LoloxonCc/ExoScout/Reviews/PDR_Redacted.pdf

## ExoScout Preliminary Design Review


## Team Name: ExoScout

### Table of Contents

1 INTRODUCTION

3
1.1 Team organisation and roles

3
1.2 Mission objectives

5
2 CANSAT

DESCRIPTION

7
2.1 Mission overview

7
2.2 Mechanical/structural design

8
2.3 Electrical design | 12
2.4 Software design | 12
2.5 Recovery system | 12
2.6 Ground support equipment | 14
3 PROJECT
PLANNING | 15
3.1 Time schedule | 15
3.2 Task list | 15
3.3 Resource estimation | 16
3.3.1 Budget | 16
4 OUTREACH PROGRAMME | 17

### 1 INTRODUCTION

1.1 Team organisation and roles
Team consists of 6 students from V High School in Bielsko-Biała, where we pursue extended programmes in math, physics and computer science. Although all of us realise the same extended subjects we present a wide variety of interdisciplinary interests and abilities. We see the CanSat competition as a great opportunity to broaden our knowledge and get experience in this type of team work. On top of that we are supported by our teacher and one of our older schoolmates, who is our mentor.
- teacher:
| ● Background:
| ● Field of work: Supervision of the team’s progress.
- mentor:
| ● Background:
| ● Field of work: Consultation. ● Hours dedicated weekly: 1 hour for consultations

Karol Synowiec - team leader:

| ● Background: Interested in math, physics and engineering. He likes understanding how machines work and is eager to explore new science achievements especially those concerning space exploration and physics related to it. He participates in contests such as Math Olympiad, Physics Olympiad, Diament AGH and more. ● Fields of work: CanSat 3D modelling in Fusion 360, electronics and team leader ● Hours dedicated weekly: 10 hours
- team member:
| ● Background:

1 https://spacecamp.no/
3

- Field of work: Software concerning sensors
- Hours dedicated weekly: 12 hours
- team member:
- Background:
- Field of work: Mechanical system development and design
- Hours dedicated weekly: 5 hours
- team member:
- Background:
- Fields of work: Recovery system, CanSat assemblement.
- Hours dedicated weekly: 10 hours
- team member:
- Background:
- Fields of work: software concerning soil intake, electronics.
- Hours dedicated weekly: 5 hours
- team member:
- Background:

4

- Fields of work: outreach, promotion
- Hours dedicated weekly: 5 hours
1.2 | Mission objectives
1.3 | Our vision
In our project we want to create CanSat which will act as a “scout” for a mission looking for a planet that can be settled by humans. After first assessments of a planet's potential habitability from space, a CanSat like device will be dropped on the planet's surface and will carry out further measurements of factors crucial to the life of the humankind. Data collected from primary and secondary missions will be used with a view to analyse multiple factors, which are considered to be vital for planetary habitability.

1.4 Primary mission
Primary mission is to measure air temperature and air pressure and to transmit it as a telemetry once per second to the ground station. Data collected from it will be used to assess if water can be liquid on the planet’s surface²

. Temperature limit for life³

is in
the range of 0 to 113 degrees Celsius, which will be also evaluated based on those measurements.

1.5 Secondary mission
Secondary mission will collect more specific data about the planet. In order to do that we divide it into the two main stages:
1. During fall CanSat will measure factors concerning planetary habitability:
| ○ Gravitational acceleration - Too high value of it makes any motion harder, blood can’t freely flow and bones can be broken due to overload⁴⁵. On the other hand low gravity implies low escape velocity, it results in molecules leaving the planet more easily and destroying its atmosphere⁶
| ○ Cosmic radiation (UV) - Radiation is both helpful and harmful⁷

. UV
| radiation takes part in biosphere processes but also affects human health. Too much of it can result in cancer but it is crucial for vitamin D3 synthesis in the body. ○ Magnetic field - without proper magnetic field the planet is not protected from stellar wind and cosmic radiation, which destroys its atmosphere and puts life at risk of being bombarded with ionized particles⁸

8 Significance part from: https://en.wikipedia.org/wiki/Earth%27s_magnetic_field

7 https://www.cdc.gov/nceh/features/uv-radiation-safety/index.html

6 extract about mass and size and hence planets gravity from https://en.m.wikipedia.org/wiki/Planetary habitability

5 https://arxiv.org/pdf/1808.07417.pdf,

4 https://www.astronomy.com/science/whats-the-maximum-gravity-we-could-survive/

3 Table 1 on page 185 http://www.geology.wisc.edu/astrobiology/docs/Lammer_et_al_2009_Astron_Astro_Rev.pdf

2 Liquid water importance from abstract of: https://pubmed.ncbi.nlm.nih.gov/11539468/

5

- Atmosphere O2 content - oxygen is vital to life as we know it. The reduction of oxygen provides one of the largest free energy release per electron transfer⁹

, so it is a great source of energy for complex life.
2. Vertical landing and taking a soil sample with Archimedes screw-like device¹⁰ to measure its humidity:
- Analysis of soil helps in the search for past water activities. Mineralogy of it is important in determining the processes that created the planet. Soil is widely analysed by rovers (f.e. on Mars)¹¹

1.6 Assessment
In conditions of the launch campaign on Earth we will test the measurements correctness by comparing them with those measured by more sophisticated devices. From the mechanical side we want to test if we can make CanSat land vertically by reducing its speed and using side stabilizers.

11 https://mars.nasa.gov/resources/4910/inspecting-soils-across-mars/

10 https://en.wikipedia.org/wiki/Archimedes%27 screw

9 https://earthscience.rice.edu/wp-content/uploads/2015/08/Catling-Astrobiology-2005.pdf

6

### 2 CANSAT DESCRIPTION

2.1 Mission overview
After launch from a rocket at a destined altitude (1500m-2500m) CanSat will deploy a parachute and side stabilizers. During the fall the device will start its measurements and reach terminal velocity of around 6 m/s in order to land vertically which will enable us to collect soil with Archimedes Screw-like mechanism after landing.

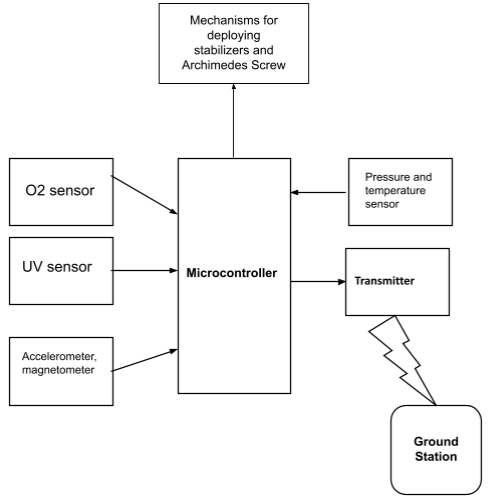
[picture p40: figure]

7

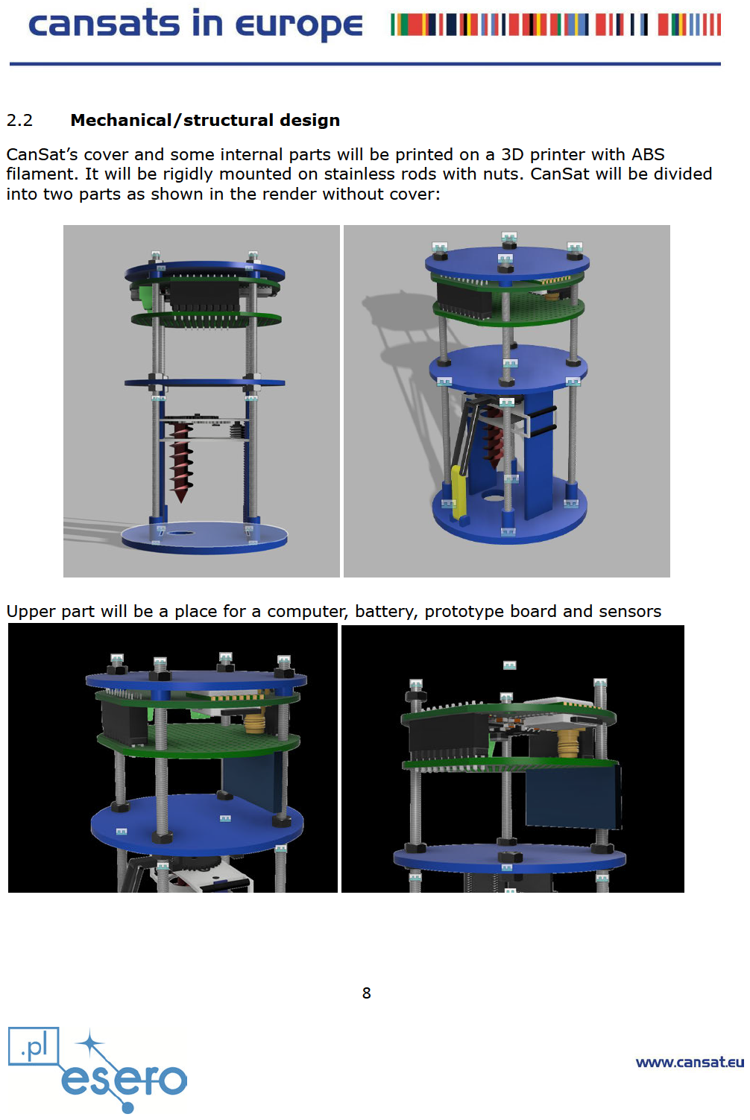
[picture p41: page 8]
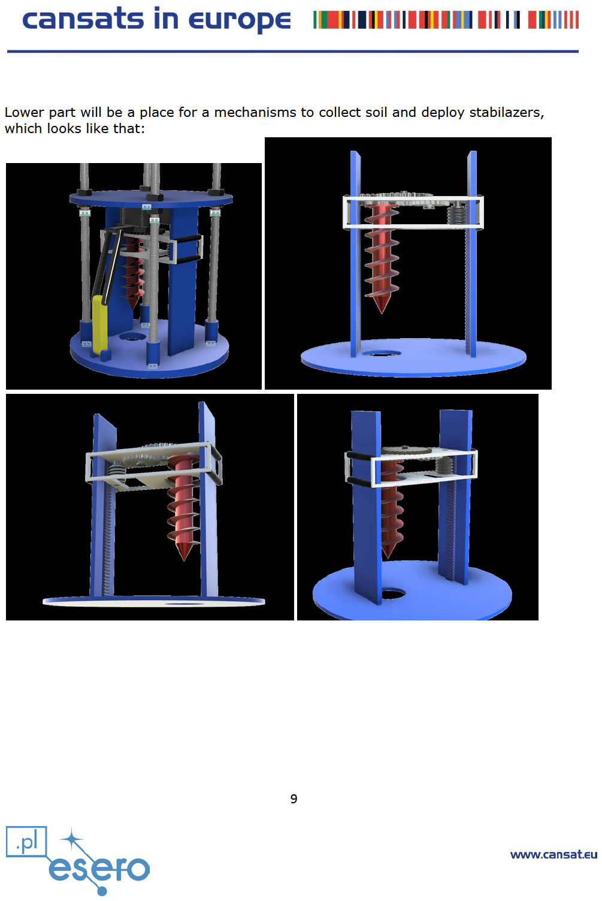
[picture p42: page 9]
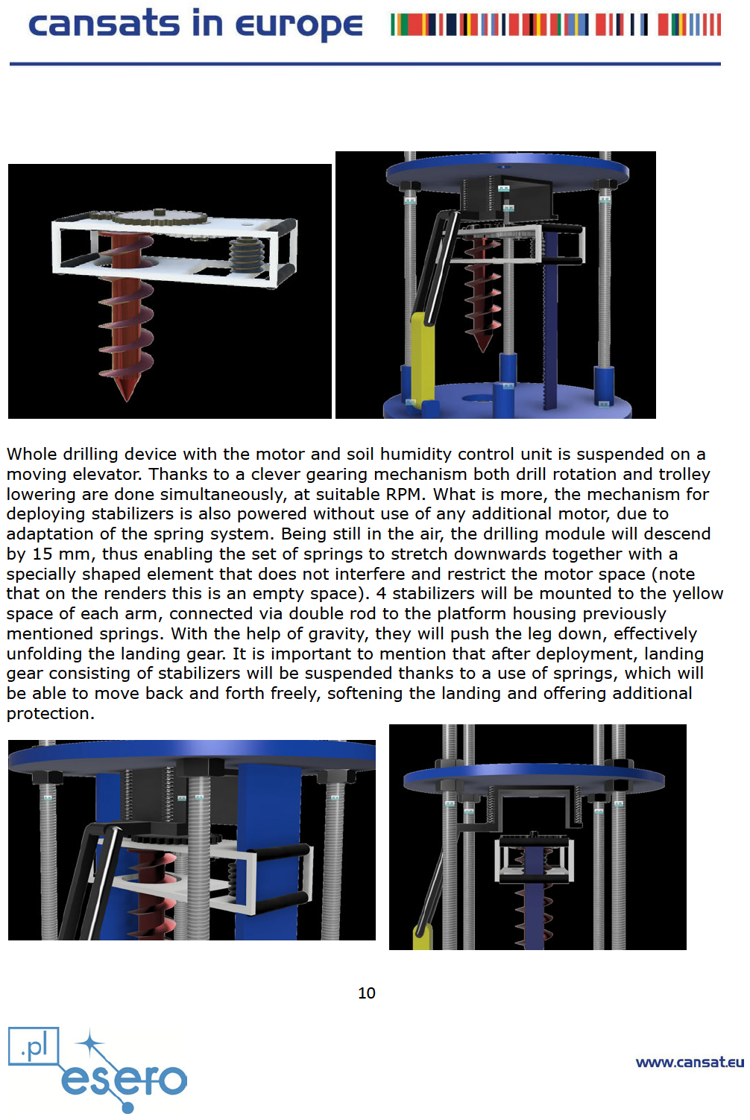
[picture p43: page 10]
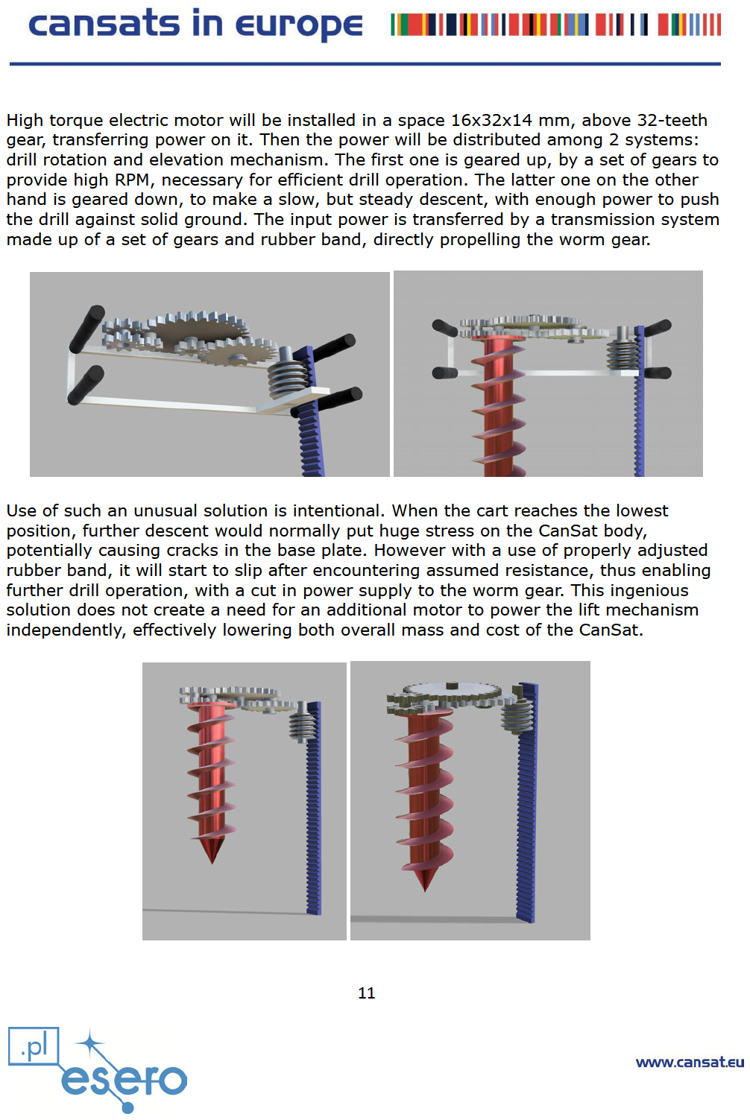
[picture p44: page 11]

Mass estimated by Fusion 360, after applying the right materials, is around 204g. After adding sensors, side stabilisers, parachute and soil intake mechanism mass will be in the range of 300-350g.

2.3 Electrical design
Electrical design includes:
| ● Computer - from CanSat kit ● Proto board - from CanSat kit ● Battery - capacity will be estimated later ● Primary mission sensors - temperature and pressure sensors from CanSat kit ● Secondary mission sensors: ○ UV sensor e.g: https://botland.store/sensors-of-light-and-color/19004-ltr390-uv-ultraviol et-light-sensor-stemma-qt-5903351249423.html ○ O2 sensor e.g: https://botland.store/gravity-gas-dust-sensors/20981-gravity-o2-sensor-i 2c-uart-factory-calibrated-dfrobot-sen0465-5904422383299.html ○ Accelerometer and magnetometer: https://botland.store/9dof-imu-sensors/17709-icm-20948-9dof-3-axis-ac celerometer-gyroscope-and-magnetometer-i2cspi-qwiic-adafruit-4554-59 04422378677.html ○ Servomotor: https://botland.com.pl/silniki-micro-pololu-seria-hp-high-power/246-silni k-hp-1001-pololu-1101-5904422306106.html

2.4 Software design
In primary mission software should plot measured temperature and pressure as a point on phase diagram¹² in order to check if water is liquid in these conditions.
In the secondary mission software will check if measured factors are in range optimal for life and send information to ground stations. Data should be live displayed on laptops with use of software like Grafana¹³. Program will also launch side stabilisers after drop from the racket and start the Archimedes screw after landing.

2.5 Recovery system¹⁴
Parachute will be made out of nylon and will have a hemispherical shape. It will be attached to the CanSat with four lines. Its area can be obtained from the equation for equilibrium of forces:

14 https://cansat.esa.int/design-your-parachute/

13 https://grafana.com/

12 https://openstax.org/books/chemistry-2e/pages/10-4-phase-diagrams

12

mg =

1
2

C
D

ρAv²
Where: m - mass of the CanSat, g - Earth acceleration, CD - drag coefficient of parachute, ρ - density of air and v is terminal velocity.
After some careful conversions we get:

A = 2mg
C
D

ρv

2
Substituting values:
g=9.81 m/s²

, CD=0.62, ρ=1.204 kg/m³

, v=6 m/s, m in range of 0.3 to 0.35 kg

We get:

0. 219 m² ≤ A ≤ 0. 255 m²
Shape of hemispherical parachute:

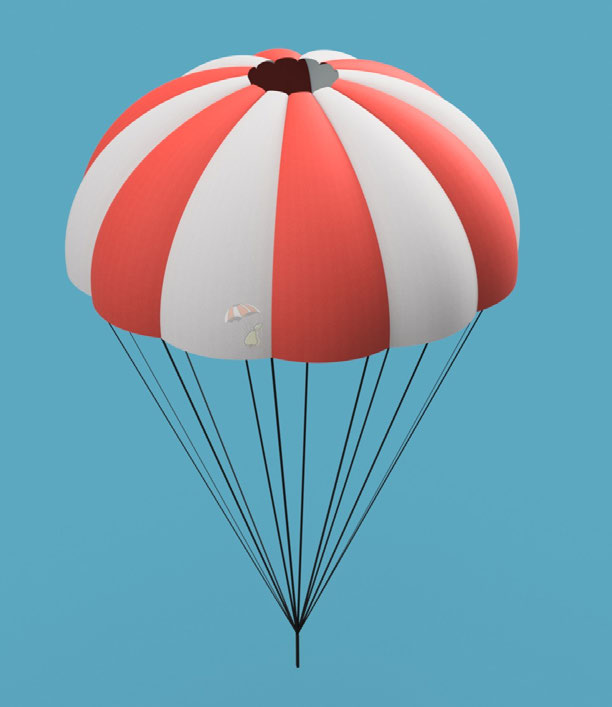
[picture p45: figure]

13

2.6 Ground support equipment¹⁵

Data from the CanSat will be transmitted to the ground station. Equipment concerned with these will consist of:
| ● Yagi-Uda antenna:

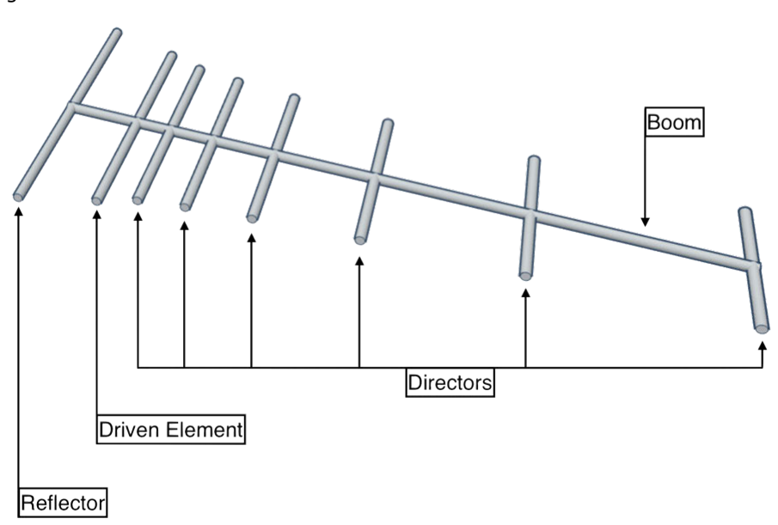
[picture p46: figure]

- Computer to display received data
- Adafruit Feather M0 RFM96 LoRa Radio for communication of antenna and the computer

15 https://cansat.esa.int/communicating-with-radio/
14

### 3 PROJECT PLANNING

3.1 Time schedule
We decided to prepare PDR in 4 one week intervals, first was for collecting information and sources for the report, second was for writing the initial version of it, third for making it more detailed and the last one for last corrections. After PDR we plan to schedule work, on each phase of the project, in 3 week-long intervals. As of now we separated 5 main stages, namely: design, prototyping, construction, tests and writing CDR. They will consist of subparts. We make a rather strict schedule (tests should start before Q&A with Jury on 9 January 2024) to make sure that even if we fail to keep some dates we can take one more week to work better on some stage of the project. Materials to write CDR such as: notes, designs, etc. will be collected during all phases and consequently put together into the report. Gantt chart presenting our schedule until CDR (from Asana):

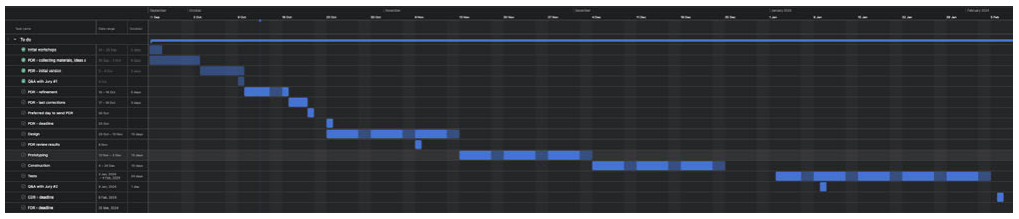
[picture p47: figure]

3.2 Task list

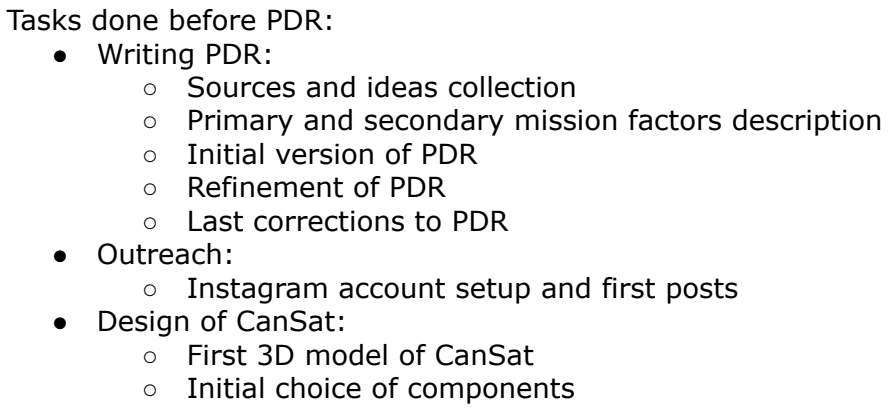
[picture p48: figure]
Tasks done before PDR: ● Writing PDR: ○ Sources and ideas collection; ○ Initial version of PDR ○ Refinement of PDR ○ Last corrections to PDR ● Outreach:; ● Design of CanSat: ○ First 3D model of CanSat ○ Initial choice of components

- Primary and secondary mission factors description
- Instagram account setup and first posts

15

Tasks to be done before CDR:
- Design:
- 3D model of CanSat with all details
- Parachute design
- Ground station design
- Electrical design
- Detailed description of software
- Prototyping
- Writing software
- Checking if parts work alone
- Making a parachute
- Construction
- Assembling all parts into a CanSat
- Mounting a parachute
- Making ground station
- Tests
- Primary mission sensors check
- Secondary mission sensors and mechanism check
- Parachute test
- Troubleshooting
- Outreach
- Weekly posts
- Budget:
- Looking for sponsors

3.3 Resource estimation

### 3.3.1 Budget

Estimation of the costs:
| ● UV sensor - 6.50 EUR ● O2 sensor - 97.50 EUR ● Accelerometer, magnetometer - 19.90 EUR ● Elements from CanSat kit - 50 EUR ● motor - 24.50 EUR

These will be the most expensive parts. Even after adding other parts (filament, screws, etc.), the budget should not exceed 300 EUR.

16

### 4 OUTREACH PROGRAMME

Even though space exploration is a hot topic now, there are still a lot of people who do not know a lot about it. In our outreach programme we want to address them and people already fascinated about the subject, so we will create content appropriate for different groups of people. In order to achieve these goals we plan actions such as:
- regular posting on social media about progresses and project objectives (Instagram, Facebook),
- own website,
- meetings with other students group to talk about space exploration and our project,
- live transmission of CanSat descent during Launch Campaign,
- presenting project on science festivals
We plan to make posts about:
- CanSat competition
- Our primary and secondary mission
- Our team
- Progresses and achievements
So far we have designed our logo which is displayed on the first site of the document and we have set up Instagram account where we started posting about our project: https://instagram.com/exoscoutteam?igshid=MzRlODBiNWFlZA==

17
