LoloxonCc/ExoScout/(list of files, cad)

Other CAD files:
Model/CanSatModel.step
